84563/USB-POWER-DISPALY/POWER_TEST_096/Core/Src/main.c

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
/* Includes ------------------------------------------------------------------*/
#include "main.h"
#include "i2c.h"
#include "tim.h"
#include "usart.h"
#include "gpio.h"

/* USER CODE BEGIN Includes */
#include "user/oled.h"
#include "user/ina220.h"
#include "user/menu.h"

#include "adc.h"
#include "user/QC_Get.h"
/* USER CODE END Includes */

/* USER CODE BEGIN PD */
#define voltage ina220_data[0]
#define current ina220_data[1]
#define power ina220_data[2]
#define energy ina220_data[3]
/* USER CODE END PD */


/* USER CODE BEGIN PV */

u16 ina220_data[4]={0,0,0,0};//电压、电流�?�功率�?�电�???????
double energy_temp=0;//电量
u8 key_enter=0,key_up=0,key_down=0,key_back=0;
u8 adj_up=0,adj_down=0;

u8 time_1s_ok=0;
u8 func_index=0;//页码

u16 mem_addr_base=0x0000;
u16 mem_addr_base_r=0x0000;

u8 oled_on=1;//开启显示
u8 data_sw=0;

/* USER CODE END PV */

void SystemClock_Config(void);
static void MX_NVIC_Init(void);
/**
  * @brief  The application entry point.
  * @retval int
  */
int main(void)
{
  /* MCU Configuration--------------------------------------------------------*/

  /* Reset of all peripherals, Initializes the Flash interface and the Systick. */
  HAL_Init();

  /* Configure the system clock */
  SystemClock_Config();

  /* Initialize all configured peripherals */
  MX_GPIO_Init();
  MX_I2C1_Init();
  MX_I2C2_Init();
  MX_USART2_UART_Init();
  MX_TIM3_Init();
  MX_TIM14_Init();

  /* Initialize interrupts */
  MX_NVIC_Init();
  /* USER CODE BEGIN 2 */
  HAL_TIM_Base_Start_IT(&htim14);
  HAL_TIM_Base_Start_IT(&htim3);
  Clear_mem();

  OLED_Init_096();		//初始化OLED
  INA220_Init();		//初始化ina220
  key_back=key_enter=key_up=key_down=0;



  /* USER CODE END 2 */

  /* Infinite loop */
  /* USER CODE BEGIN WHILE */
  while (1)
  {

	  OLED_Refresh();
//	  if(INA220_CNVR())//When the conversion is complete
	  if(time_1s_ok)
	  {
		  time_1s_ok=0;
		  voltage     = INA220_GetVoltage();
		  current     = INA220_GetCurrent();
		  power       = INA220_GetPower();
		  energy_temp = energy_temp + power*0.00027777;
		  energy      = energy_temp;

		  if(power!=0&&mem_addr_base<0xE00)
		  {
			  HAL_I2C_Mem_Write(&hi2c1,0xA0,mem_addr_base,I2C_MEMADD_SIZE_16BIT,(u8*)ina220_data,4,100);
			  mem_addr_base=mem_addr_base+4;
		  }
	  }

	  /*******************find index****************************/
	  if((key_enter==1)||(key_up==1)||(key_down==1))
	  {
		  if(key_up==1)
		  {
			  func_index=table[func_index].up;    //up
			  key_up=0;
		  }
		  if(key_down==1)
		  {
			  func_index=table[func_index].down;    //down
			  key_down=0;
		  }
		  if(key_enter==1)
		  {
			  OLED_Clear();
			  func_index=table[func_index].enter;    //enter
			  key_enter=0;
		  }

	  }
	  if(key_back==1)
	  {
		  key_back=0;
		  if(oled_on==1)
			  oled_on=0;
		  else
			  oled_on=1;
	  }
	  current_operation_index=table[func_index].current_operation;
	  (*current_operation_index)();//执行当前操作函数

	  HAL_Delay(10);


    /* USER CODE END WHILE */

    /* USER CODE BEGIN 3 */
  }
  /* USER CODE END 3 */
}

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
/* USER CODE BEGIN 4 */


//按键外部中断回调函数
void HAL_GPIO_EXTI_Rising_Callback(uint16_t GPIO_Pin)
{
	HAL_NVIC_DisableIRQ(EXTI4_15_IRQn);//消抖，关闭中断
	__HAL_TIM_ENABLE(&htim14);//启动定时器，消抖时间到后再开启中断

	if(GPIO_Pin==GPIO_PIN_4)
	{
		key_back=1;
		if(func_index==9)
			data_sw=1;
	}
	if(GPIO_Pin==GPIO_PIN_5)
	{
		key_down=1;
		if(func_index==5||func_index==9||func_index==10||func_index==11)//向下调节
			adj_down=1;
	}
	if(GPIO_Pin==GPIO_PIN_6)
	{
		key_up=1;
		if(func_index==5||func_index==9||func_index==10||func_index==11)//向上调节
			adj_up=1;
	}
	if(GPIO_Pin==GPIO_PIN_7)
	{
		key_enter=1;
		if(func_index==10||func_index==11)//退出QC
			QC_DeInit();
		if(func_index==9)
			mem_addr_base_r=0;
	}
}
//tim中断回调函数
void HAL_TIM_PeriodElapsedCallback(TIM_HandleTypeDef *htim)
{
	if(htim == &htim3)
	{
		time_1s_ok=1;//1s时间到
	}
	if(htim == &htim14)
	{
		HAL_NVIC_EnableIRQ(EXTI4_15_IRQn);//消抖结束，开启中断
	}

}
/* USER CODE END 4 */
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
