84563/USB-POWER-DISPALY/POWER_TEST_096/POWER_TEST_096.ioc

Mcu.UserName=STM32G030F6Px
PA0.Signal=ADC1_IN0
PA2.Signal=USART2_TX
PA3.Signal=USART2_RX
PA4.Signal=GPXTI4
PA5.Signal=GPXTI5
PA6.Signal=GPXTI6
PA7.Signal=GPXTI7
PB8.Signal=I2C1_SCL
PB9.Signal=I2C1_SDA
