84563/USB-POWER-DISPALY/POWER_TEST_096/Core/Src/user/oled.c

/*
 * oled.c
 *
 *  Created on: Feb 19, 2022
 *      Author: Feng
 */
#include "user/oled.h"
#include "stdlib.h"
#include "user/oledfont.h"

extern I2C_HandleTypeDef hi2c2;

u8 OLED_GRAM[8][128];//显存


void Write_IIC_Command(unsigned char I2C_Command)//写命令
{
    uint8_t *pData;
    pData = &I2C_Command;
	HAL_I2C_Mem_Write(&hi2c2,OLED_ADDRESS,0x00,I2C_MEMADD_SIZE_8BIT,pData,1,100);
}

/*HAL_I2C_Mem_Write()说明
 * 第1个参数为I2C操作句柄
   第2个参数为从机设备地址
   第3个参数为从机寄存器地址
   第4个参数为从机寄存器地址长度
   第5个参数为发送的数据
   第6个参数为传输数据的大小
   第7个参数为操作超时时间 　　*/

void Write_IIC_Data(unsigned char IIC_Data)//写数据
{
    uint8_t *pData;
    pData = &IIC_Data;
	HAL_I2C_Mem_Write(&hi2c2,OLED_ADDRESS,0x40,I2C_MEMADD_SIZE_8BIT,pData,1,100);
}
/*
void Write_IIC_Gram(unsigned char IIC_Gram)//写显存
{
	uint8_t *pData;
	pData = &IIC_Gram;
	HAL_I2C_Mem_Write(&hi2c2,OLED_ADDRESS,0x40,I2C_MEMADD_SIZE_8BIT,pData,128,100);
}
*/

void OLED_WR_Byte(unsigned dat,unsigned cmd)//写1字节
{
	if(cmd)
	{
		Write_IIC_Data(dat);
	}
	else
	{
		Write_IIC_Command(dat);
	}
}


//更新显存到OLED
void OLED_Refresh(void)
{
	u8 i;
	for(i=0;i<8;i++)
	{
		OLED_WR_Byte(0xb0+i,OLED_CMD); //设置行起始地址
		OLED_WR_Byte(0x00,OLED_CMD);   //设置低列起始地址
		OLED_WR_Byte(0x10,OLED_CMD);   //设置高列起始地址
		HAL_I2C_Mem_Write(&hi2c2,OLED_ADDRESS,0x40,I2C_MEMADD_SIZE_8BIT,&OLED_GRAM[i][0],128,100);
		//写入显存
	}
}



// fill_Picture
/*void fill_picture(unsigned char fill_Data)
{
	unsigned char m,n;
	for(m=0;m<4;m++)
	{
		OLED_WR_Byte(0xb0+m,0);		//page0-page1
		OLED_WR_Byte(0x00,0);		//low column start address
		OLED_WR_Byte(0x10,0);		//high column start address
		for(n=0;n<128;n++)
			{
				OLED_WR_Byte(fill_Data,1);
			}
	}
}*/

//坐标设置
/*void OLED_Set_Pos(unsigned char x, unsigned char y)

{
	OLED_WR_Byte(0xb0+y,OLED_CMD);
	OLED_WR_Byte(((x&0xf0)>>4)|0x10,OLED_CMD);
	OLED_WR_Byte((x&0x0f),OLED_CMD);
}*/


//开启OLED显示
void OLED_Display_On(void)
{
	OLED_WR_Byte(0X8D,OLED_CMD);  //SET DCDC命令
	OLED_WR_Byte(0X14,OLED_CMD);  //DCDC ON
	OLED_WR_Byte(0XAF,OLED_CMD);  //DISPLAY ON
}
//关闭OLED显示

void OLED_Display_Off(void)
{
	OLED_WR_Byte(0X8D,OLED_CMD);  //SET DCDC命令
	OLED_WR_Byte(0X10,OLED_CMD);  //DCDC OFF
	OLED_WR_Byte(0XAE,OLED_CMD);  //DISPLAY OFF
}

//清屏

//清屏
void OLED_Clear(void)
{
	u8 i,j;
	for(i=0;i<8;i++)	//清空显示缓冲区
	for(j=0;j<128;j++)
		OLED_GRAM[i][j]=0;
	OLED_Refresh();		//刷新显存
}


//点亮整个屏幕
void OLED_On(void)
{
	u8 i,j;
	for(i=0;i<8;i++)	//清空显示缓冲区
	for(j=0;j<128;j++)
		OLED_GRAM[i][j]=255;
//	OLED_Refresh();		//刷新显存
}


//画点
//x:0~127
//y:0~31
//t:1 填充 0,清空
void OLED_DrawPoint(u8 x,u8 y,u8 t)
{
	u8 i,m,n;
	i=y/8;
	m=y%8;
	n=1<<m;
	if(t){OLED_GRAM[i][x]|=n;}
	else
	{
		OLED_GRAM[i][x]=~OLED_GRAM[i][x];
		OLED_GRAM[i][x]|=n;
		OLED_GRAM[i][x]=~OLED_GRAM[i][x];
	}
}


//画线
//x1,y1:起点坐标
//x2,y2:结束坐标
void OLED_DrawLine(u8 x1,u8 y1,u8 x2,u8 y2,u8 mode)
{
	u16 t;
	int xerr=0,yerr=0,delta_x,delta_y,distance;
	int incx,incy,uRow,uCol;
	delta_x=x2-x1; //计算坐标增量
	delta_y=y2-y1;
	uRow=x1;//画线起点坐标
	uCol=y1;
	if(delta_x>0)incx=1; //设置单步方向
	else if (delta_x==0)incx=0;//垂直线
	else {incx=-1;delta_x=-delta_x;}
	if(delta_y>0)incy=1;
	else if (delta_y==0)incy=0;//水平线
	else {incy=-1;delta_y=-delta_x;}
	if(delta_x>delta_y)distance=delta_x; //选取基本增量坐标轴
	else distance=delta_y;
	for(t=0;t<distance+1;t++)
	{
		OLED_DrawPoint(uRow,uCol,mode);//画点
		xerr+=delta_x;
		yerr+=delta_y;
		if(xerr>distance)
		{
			xerr-=distance;
			uRow+=incx;
		}
		if(yerr>distance)
		{
			yerr-=distance;
			uCol+=incy;
		}
	}
}


//画圆
//x,y:圆心坐标
//r:圆的半径
/*void OLED_DrawCircle(u8 x,u8 y,u8 r)
{
	int a, b,num;
    a = 0;
    b = r;
    while(2 * b * b >= r * r)
    {
        OLED_DrawPoint(x + a, y - b,1);
        OLED_DrawPoint(x - a, y - b,1);
        OLED_DrawPoint(x - a, y + b,1);
        OLED_DrawPoint(x + a, y + b,1);

        OLED_DrawPoint(x + b, y + a,1);
        OLED_DrawPoint(x + b, y - a,1);
        OLED_DrawPoint(x - b, y - a,1);
        OLED_DrawPoint(x - b, y + a,1);

        a++;
        num = (a * a + b * b) - r*r;//计算画的点离圆心的距离
        if(num > 0)
        {
            b--;
            a--;
        }
    }
}*/


//在指定位置显示一个字符,包括部分字符
//x:0~127
//y:0~63
//size1:选择字体 6x8/6x12/8x16/12x24
//mode:0,反色显示;1,正常显示;2,清除显示
void OLED_ShowChar(u8 x,u8 y,u8 chr,u8 size1,u8 mode)
{
	u8 i,m,temp,size2,chr1;
	u8 x0=x,y0=y;
	if(size1==8)size2=6;
	else size2=(size1/8+((size1%8)?1:0))*(size1/2);  //得到字体一个字符对应点阵集所占的字节数
	chr1=chr-' ';  //计算偏移后的值
	for(i=0;i<size2;i++)
	{
		if(size1==8)
			  {temp=asc2_0806[chr1][i];} //调用0806字体
		else if(size1==12)
        {temp=asc2_1206[chr1][i];} //调用1206字体
		else if(size1==16)
        {temp=asc2_1608[chr1][i];} //调用1608字体
//		else if(size1==24)
//        {temp=asc2_2412[chr1][i];} //调用2412字体
		else return;
		if(mode==2)
		for(m=0;m<8;m++)
		{
			if(temp&0x01)OLED_DrawPoint(x,y,0);
			else OLED_DrawPoint(x,y,0);
			temp>>=1;
			y++;
		}
		else
		for(m=0;m<8;m++)
		{
			if(temp&0x01)OLED_DrawPoint(x,y,mode);
			else OLED_DrawPoint(x,y,!mode);
			temp>>=1;
			y++;
		}
		x++;
		if((size1!=8)&&((x-x0)==size1/2))
		{x=x0;y0=y0+8;}
		y=y0;
  }
}

//水平显示字符串
//x,y:起点坐标
//size1:字体大小
//*chr:字符串起始地址
//mode:0,反色显示;1,正常显示
void OLED_ShowString_H(u8 x,u8 y,u8 *chr,u8 size1,u8 mode)
{
	while((*chr>=' ')&&(*chr<='~'))//判断是不是非法字符!
	{
		OLED_ShowChar(x,y,*chr,size1,mode);
		if(size1==8)x+=6;
		else x+=size1/2;
		chr++;
	}
}
//垂直显示字符串
void OLED_ShowString_V(u8 x,u8 y,u8 *chr,u8 size1,u8 mode)
{
	while((*chr>=' ')&&(*chr<='~'))//判断是不是非法字符!
	{
		OLED_ShowChar(x,y,*chr,size1,mode);
		//if(size1==8)x+=6;
		//else x+=size1/2;
		y+=size1;
		chr++;
	}
}


//m^n
u32 OLED_Pow(u8 m,u8 n)
{
	u32 result=1;
	while(n--)
	{
	  result*=m;
	}
	return result;
}

//显示数字
//x,y :起点坐标
//len :数字的位数
//size:字体大小
//mode:0,反色显示;1,正常显示
void OLED_ShowNum(u8 x,u8 y,u32 num,u8 len,u8 size1,u8 mode)
{
	u8 t,temp,m=0;
	if(size1==8)m=2;
	for(t=0;t<len;t++)
	{
		temp=(num/OLED_Pow(10,len-t-1))%10;
			if(temp==0)
			{
				OLED_ShowChar(x+(size1/2+m)*t,y,'0',size1,mode);
      }
			else
			{
			  OLED_ShowChar(x+(size1/2+m)*t,y,temp+'0',size1,mode);
			}
   }
}

//显示定点数
void OLED_ShowDotNum(u8 x,u8 y,u32 num,u8 len,u8 size1,u8 mode)
{
	u8 t,temp,m=0;


	if(size1==8)m=2;
	for(t=0;t<len;t++)
	{
		if(t==2)
		{
			OLED_ShowChar(x+(size1/2+m)*t-1,y,46,size1,mode);
			x+=3;
		}
		temp=(num/OLED_Pow(10,len-t-1))%10;
		if(temp==0)
		{
			OLED_ShowChar(x+(size1/2+m)*t,y,'0',size1,mode);
		}
		else
		{
			OLED_ShowChar(x+(size1/2+m)*t,y,temp+'0',size1,mode);
		}
	}
}

//显示汉字
//x,y:起点坐标
//num:汉字对应的序号
//mode:0,反色显示;1,正常显示
void OLED_ShowChinese(u8 x,u8 y,u8 num,u8 size1,u8 mode)
{
	u8 m,temp;
	u8 x0=x,y0=y;
	u16 i,size3=(size1/8+((size1%8)?1:0))*size1;  //得到字体一个字符对应点阵集所占的字节数
	for(i=0;i<size3;i++)
	{
		if(size1==12)
				{temp=Hzk1[num][i];}//调用16*16字体
/*		else if(size1==24)
				{temp=Hzk2[num][i];}//调用24*24字体
		else if(size1==32)
				{temp=Hzk3[num][i];}//调用32*32字体
		else if(size1==64)
				{temp=Hzk4[num][i];}//调用64*64字体
*/
		else return;
		for(m=0;m<8;m++)
		{
			if(temp&0x01)OLED_DrawPoint(x,y,mode);
			else OLED_DrawPoint(x,y,!mode);
			temp>>=1;
			y++;
		}
		x++;
		if((x-x0)==size1)
		{x=x0;y0=y0+8;}
		y=y0;
	}
}




//OLED的初始化
void OLED_Init_096(void)
{
	OLED_WR_Byte(0xAE,OLED_CMD);//--turn off oled panel
	OLED_WR_Byte(0x00,OLED_CMD);//---set low column address
	OLED_WR_Byte(0x10,OLED_CMD);//---set high column address
	OLED_WR_Byte(0x40,OLED_CMD);//--set start line address  Set Mapping RAM Display Start Line (0x00~0x3F)
	OLED_WR_Byte(0x81,OLED_CMD);//--set contrast control register
	OLED_WR_Byte(0xCD,OLED_CMD);// Set SEG Output Current Brightness
	OLED_WR_Byte(0xA1,OLED_CMD);//--Set SEG/Column Mapping     0xa0左右反置 0xa1正常
	OLED_WR_Byte(0xC8,OLED_CMD);//Set COM/Row Scan Direction   0xc0上下反置 0xc8正常
	OLED_WR_Byte(0xA6,OLED_CMD);//--set normal display
	OLED_WR_Byte(0xA8,OLED_CMD);//--set multiplex ratio(1 to 64)
	OLED_WR_Byte(0x3f,OLED_CMD);//--1/64 duty
	OLED_WR_Byte(0xD3,OLED_CMD);//-set display offset	Shift Mapping RAM Counter (0x00~0x3F)
	OLED_WR_Byte(0x00,OLED_CMD);//-not offset
	OLED_WR_Byte(0xd5,OLED_CMD);//--set display clock divide ratio/oscillator frequency
	OLED_WR_Byte(0x80,OLED_CMD);//--set divide ratio, Set Clock as 100 Frames/Sec
	OLED_WR_Byte(0xD9,OLED_CMD);//--set pre-charge period
	OLED_WR_Byte(0xF1,OLED_CMD);//Set Pre-Charge as 15 Clocks & Discharge as 1 Clock
	OLED_WR_Byte(0xDA,OLED_CMD);//--set com pins hardware configuration
	OLED_WR_Byte(0x12,OLED_CMD);
	OLED_WR_Byte(0xDB,OLED_CMD);//--set vcomh
	OLED_WR_Byte(0x30,OLED_CMD);//Set VCOM Deselect Level
	OLED_WR_Byte(0x20,OLED_CMD);//-Set Page Addressing Mode (0x00/0x01/0x02)
	OLED_WR_Byte(0x02,OLED_CMD);//
	OLED_WR_Byte(0x8D,OLED_CMD);//--set Charge Pump enable/disable
	OLED_WR_Byte(0x14,OLED_CMD);//--set(0x10) disable
	OLED_Clear();
	OLED_WR_Byte(0xAF,OLED_CMD);
}
