84563/USB-POWER-DISPALY/(notices)

Notices in the files:
POWER_TEST_096/Core/Src/usart.c:
Copyright (c) 2022 STMicroelectronics.
All rights reserved.
This software is licensed under terms that can be found in the LICENSE file
